wrutkowski/quadruped/docs/projects.md

---
layout: project
title: Videos
permalink: /videos/
---

A few videos of the robot.
