wrutkowski/quadruped/docs/_posts/2017-04-22-pwm-driver.md

---
layout: post
title:  "PWM Driver - a cure for shakes?"
date:   2017-04-22 14:00:00
---
I've received PWM Driver. I hoped that it will resolve shakes issue. I wanted to try it as soon as possible. Pins were not soldered so that was I first step.

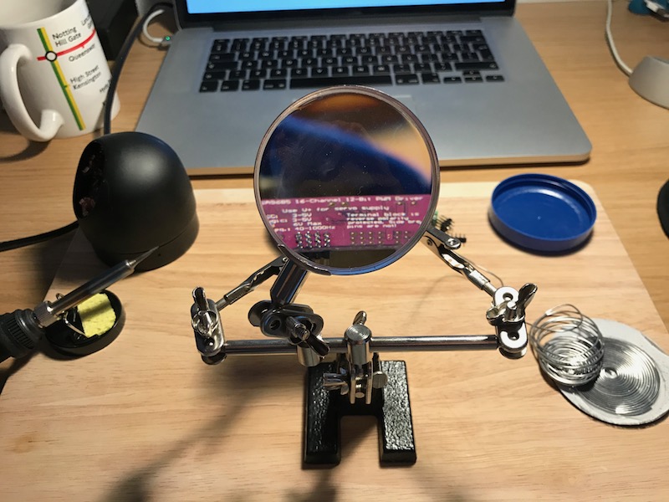
[picture p12: docs/assets/pwm-driver-soldering.jpg]
PRM Driver soldering


I placed 4 standoffs for PWM Driver on the robot body and then I connected all servos. I had to adjust servo-commander script as [PWM Driver library from Adafruit](https://github.com/adafruit/Adafruit-PWM-Servo-Driver-Library) accept _pulse width_ instead of angles as _Servo_ library.

I added for loop to change pulse width gradually hoping it'll help for the shakes as well.

```
void setServo(uint8_t servoNumber, int oldValue, int newValue, bool force = false) {
    if (newValue == oldValue && !force) return;

    if (newValue > oldValue) {
        for (uint16_t pulselen = oldValue; pulselen <= newValue; pulselen++) {
            pwm.setPWM(servoNumber, 0, pulselen);
        }
    } else {
        for (uint16_t pulselen = oldValue; pulselen >= newValue; pulselen--) {
            pwm.setPWM(servoNumber, 0, pulselen);
        }
    }
}
```

Standoffs ready for the Driver
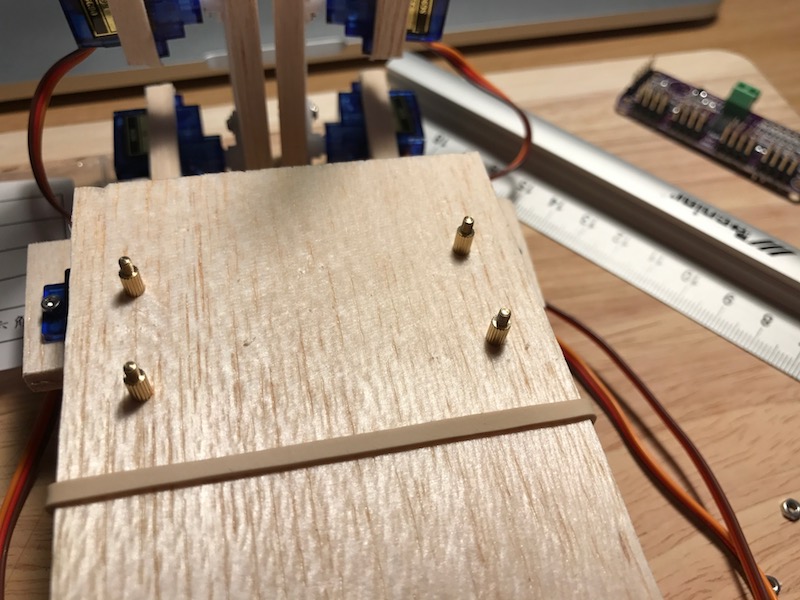
[picture p13: docs/assets/pwm-driver-standoffs.jpg]
Standoffs ready for the Driver


PWM Driver with servos connected
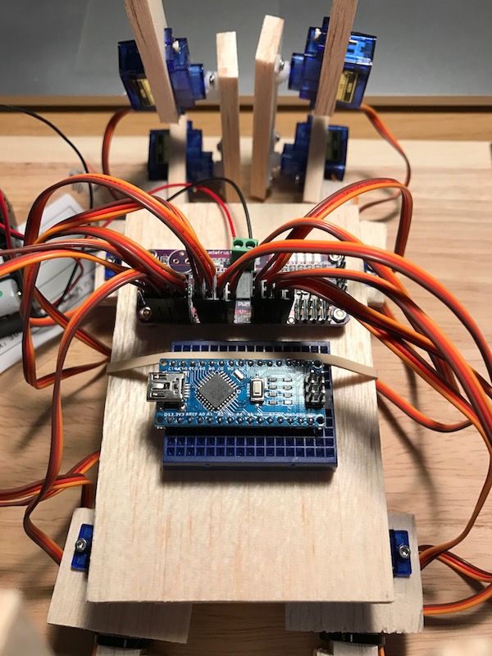
[picture p14: docs/assets/pwm-driver-with-servos-connected.jpg]
PWM Driver with servos connected


You can see PWM driver didn't help - shaking is still there.

PWM Driver - robot shakes

In the documentation I found the point about [soldering capacitor to the driver](https://learn.adafruit.com/16-channel-pwm-servo-driver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). For 12 servos it should be 1200uF capacitor. I didn't have one, but I'll grab one from the nearby electronic store tomorrow.
