wrutkowski/quadruped/docs/_posts/2017-05-20-new-construction-acrylic.md

---
layout: post
title:  "New construction - acrylic"
date:   2017-05-20 01:00:00
---
After trying to make balsa wood construction to work for a couple of times I decided I'll try shorter, more sturdy legs made from acrylic. I ordered 5 of those legs (one for a backup) from ebay.

I disassembled one leg and attached servos to the new acrylic parts.

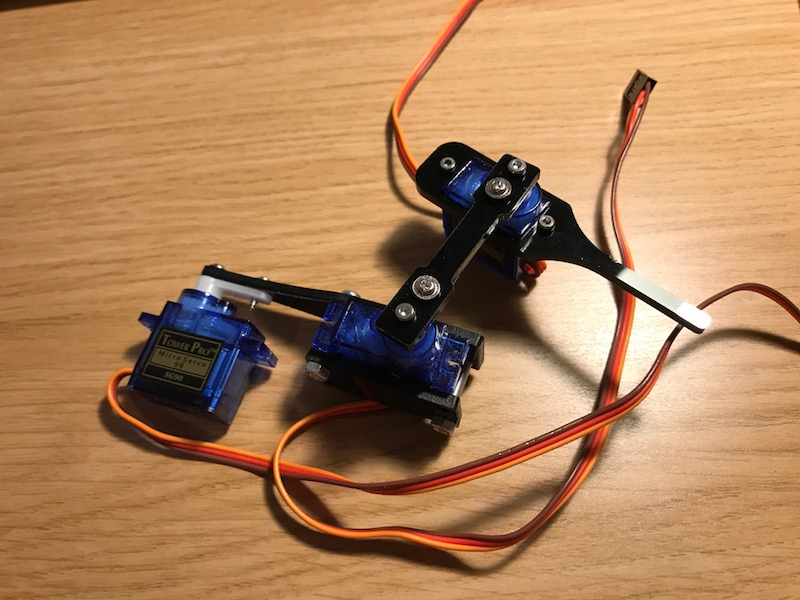
[picture p22: docs/assets/acrylic-leg-mounted.jpg]
Acrylic leg mounted


It was a lot more sturdy than longer balsa construction so I followed the same steps for other legs.

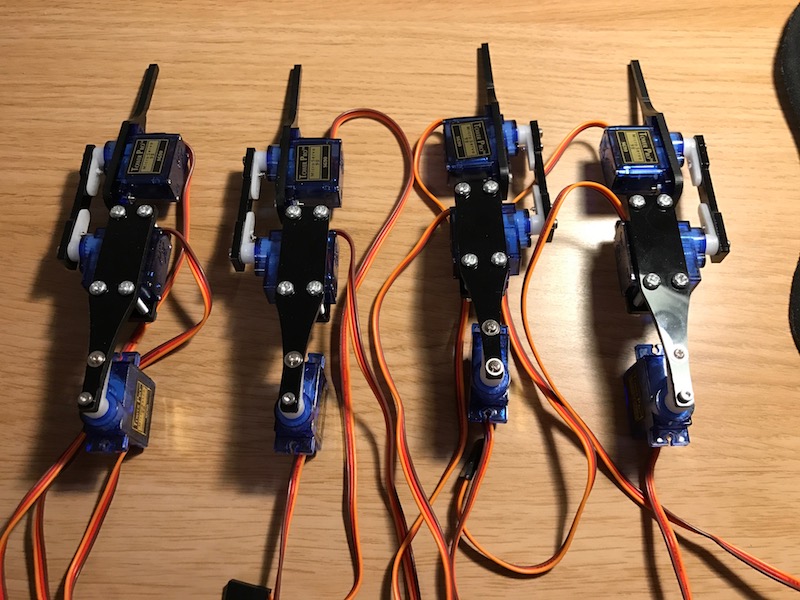
[picture p23: docs/assets/four-new-acrylic-legs.jpg]
4 new acrylic legs


Together with legs I ordered A4 sheet of 3mm acrylic to make a body. I cut 4 holes for servos and drilled several holes for screws for servos and pads for PWM Driver and on/off switch.

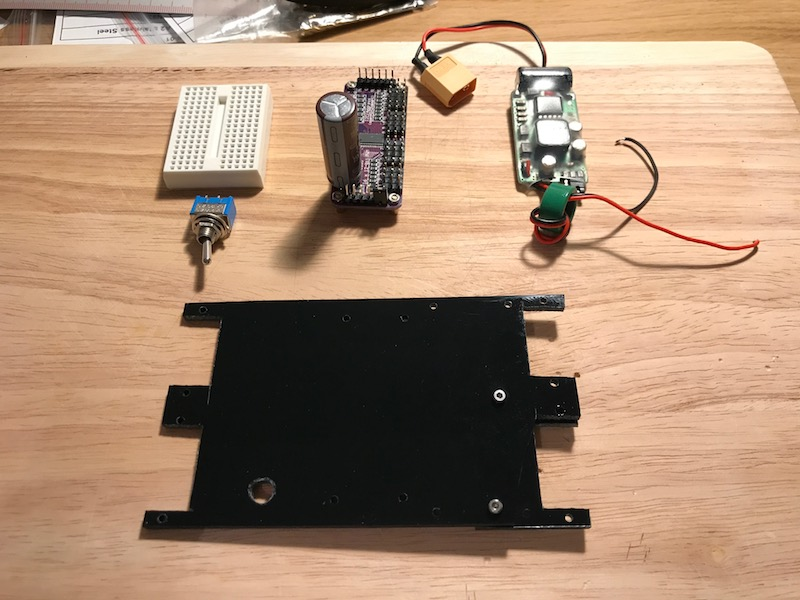
[picture p24: docs/assets/body-and-components.jpg]
Body and robot's components waiting to be installed


New acrylic construction:
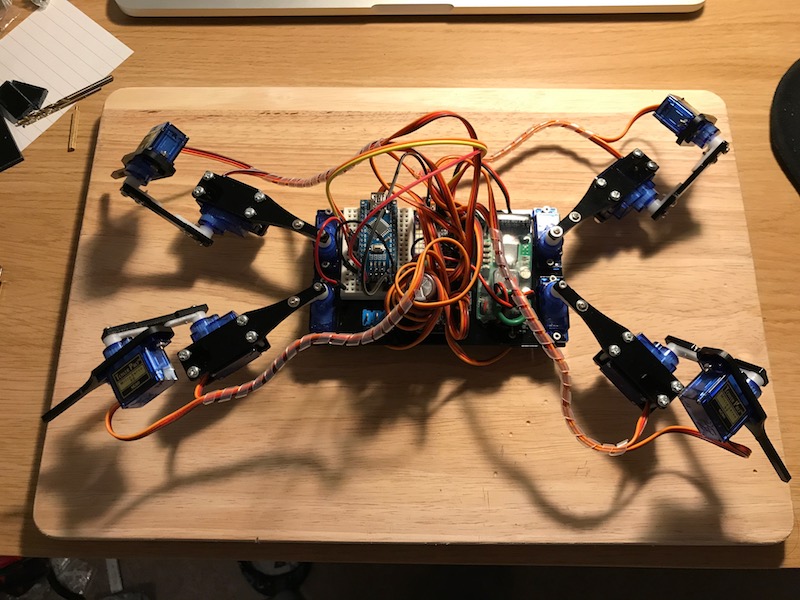
[picture p25: docs/assets/quadruped-new-acrylic-construction.jpg]
New acrylic construction


I adjusted body size and legs lengths settings in the code. Run calibration process again and without changing walk methods robot started walking for the first time! 😄

New Acrylic Robot Walking for the first time

It **was** worth switching to acrylic.
