wrutkowski/quadruped/docs/_posts/2017-04-19-servos-testing.md

---
layout: post
title:  "Servos testing + robot base with 4 legs"
date:   2017-04-19 20:00:00
---
Servos arrived. I tried to fit them to leg parts that I created several days ago as I’ve heard that cheap 9g servos can differ in sizes a bit. They were exactly the same size as my one old servo from previous project, so after some drilling and screwing first leg was ready.

First robot leg constructed with testing circuit

I don't have a PWM Driver yet and I didn't want to put USB under too much draw from three servos so I decided to create a simple circuit with potentiometer and a button. I read the analog input from the potentiometer to set the servo angle and button switches between hip, thigh and tibia servos. All worked OK and the material was sturdy enough so I decided to create other 3 legs.

Mass production begins 😄 It's just a quadruped, it's hard to imagine how repetitive it is for 6 or 8 leg robot.

Balsa wood elements cut
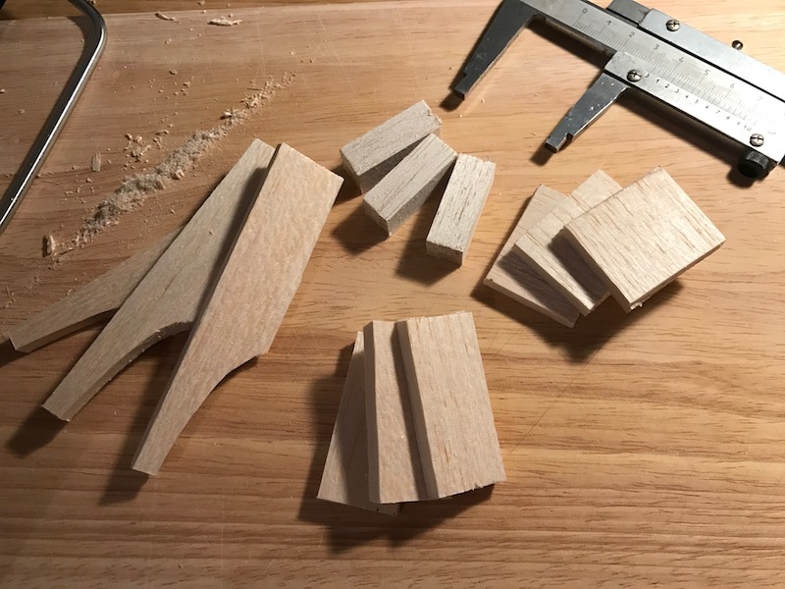
[picture p31: docs/assets/balsa-wood-elements-cut-for-3-legs.jpg]
Balsa wood elements cut


Clamp on glued hip-thigh element
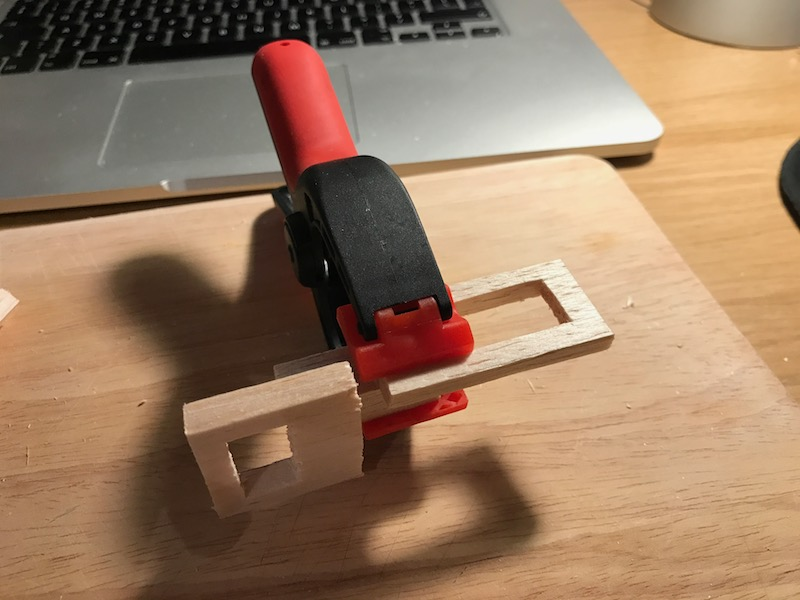
[picture p32: docs/assets/clamp-on-glued-hip-thigh-element.jpg]
Clamp on glued hip-thigh element


Thigh with servo full arms attached
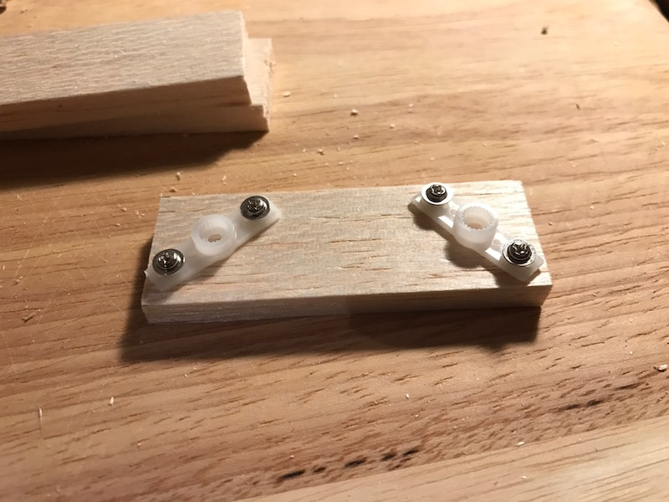
[picture p33: docs/assets/thigh-with-servo-full-arms-attached.jpg]
Thigh with servo full arms attached


Legs are ready!
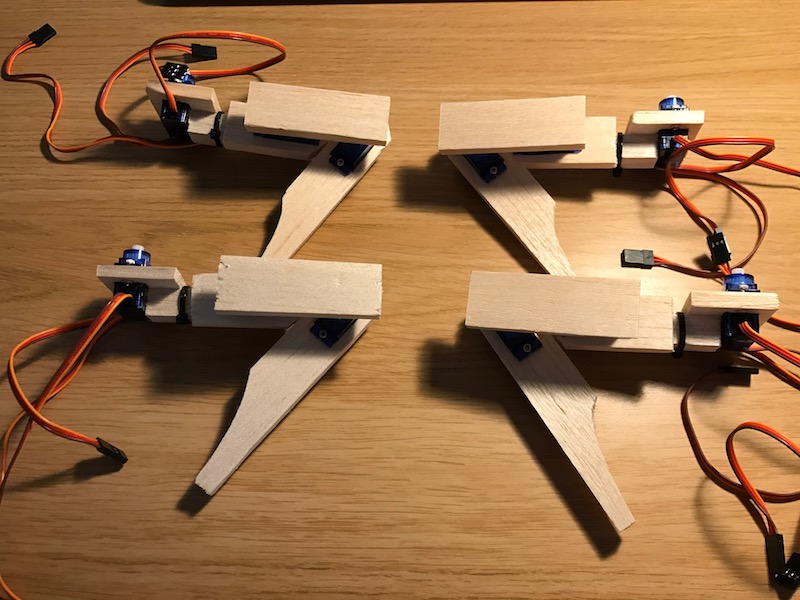
[picture p34: docs/assets/quadruped-three-new-legs.jpg]
Legs are ready!


And finally connected to the robot
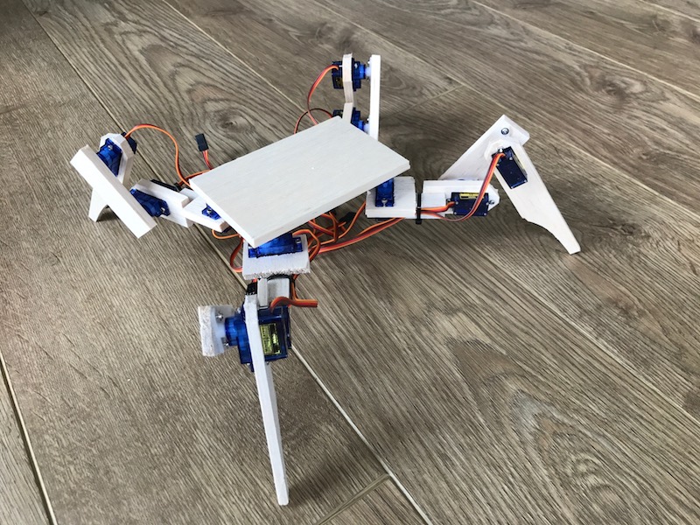
[picture p35: docs/assets/robot-body-with-legs-attached.jpg]
And finally connected to the robot
