wrutkowski/quadruped/(list of files, drawings)

Other design files:
arduino/_libraries/rfid/doc/fritzing/Arduino-Uno-r3-with-RFID-RC522.fzz
arduino/_libraries/Ultrasonic/extras/Ultrasonic.fzz
