wrutkowski/quadruped/arduino/rfid-controlled-oled/rfid-controlled-oled.ino

/* Typical pin layout used:
 * -----------------------------------------------------------------------------------------
 *             MFRC522      Arduino       Arduino   Arduino    Arduino          Arduino
 *             Reader/PCD   Uno/101       Mega      Nano v3    Leonardo/Micro   Pro Micro
 * Signal      Pin          Pin           Pin       Pin        Pin              Pin
 * -----------------------------------------------------------------------------------------
 * RST/Reset   RST          9             5         D9         RESET/ICSP-5     RST
 * SPI SS      SDA(SS)      10            53        D10        10               10
 * SPI MOSI    MOSI         11 / ICSP-4   51        D11        ICSP-4           16
 * SPI MISO    MISO         12 / ICSP-1   50        D12        ICSP-1           14
 * SPI SCK     SCK          13 / ICSP-3   52        D13        ICSP-3           15
 */

#include <SPI.h>
#include <MFRC522.h>
#include "SH1106_SPI.h"

#define RST_PIN         7     
#define SS_PIN          6    

MFRC522 mfrc522(SS_PIN, RST_PIN);
SH1106_SPI_FB lcd;
uint8_t smile_step = 0;
uint8_t smile_steps = 4;

byte keyringRFID[4] = {0xF5, 0x68, 0xCD, 0x65};
byte cardRFID[4] = {0x68, 0x4D, 0xEC, 0x10};
byte readCard[4];

void setup(void) {
    Serial.begin(9600);
    SPI.begin();
    mfrc522.PCD_Init();    
//    mfrc522.PCD_DumpVersionToSerial();  // Show details of PCD - MFRC522 Card Reader details

    lcd.begin();
    
    Serial.println("Ready!");
}

void loop() {
    lcd.clear();

    if (getID()) {
        if (checkRFID(readCard, keyringRFID)) {
            Serial.println("keyring detected");
            emotion_happiness();
            lcd.renderAll();
            delay(1000);
        } else if (checkRFID(readCard, cardRFID)) {
            Serial.println("card detected");
            emotion_sadness();
            lcd.renderAll();
            delay(1000);
        }
    } else {
        if (smile_step == 0) emotion_looking_around_1();
        if (smile_step == 1) emotion_looking_around_2();
        if (smile_step == 2) emotion_looking_around_1();
        if (smile_step == 3) emotion_looking_around_3();
        lcd.renderAll();

        delay(400);
        
        smile_step++;
        if (smile_step >= smile_steps) smile_step = 0;
    }
}

uint8_t getID() {
    // Getting ready for Reading PICCs
    if ( ! mfrc522.PICC_IsNewCardPresent()) { //If a new PICC placed to RFID reader continue
        return 0;
    }
    if ( ! mfrc522.PICC_ReadCardSerial()) {   //Since a PICC placed get Serial and continue
        return 0;
    } 
    for ( uint8_t i = 0; i < 4; i++) {  //
        readCard[i] = mfrc522.uid.uidByte[i];
//        Serial.print(readCard[i], HEX);
    }
  
    mfrc522.PICC_HaltA(); // Stop reading
    return 1;
}

boolean checkRFID ( byte a[], byte b[] ) {
    boolean match = false;
    if ( a[0] != 0 ) {
        match = true;       // Assume they match at first
    }
    
    for (uint8_t k = 0; k < 4; k++ ) {
        if (a[k] != b[k]) {     // IF a != b then set match = false, one fails, all fail
            match = false;
        }
    }
    return match;
}

// emotions

void emotion_anger() {
    lcd.setPixel(38, 51, 1); lcd.setPixel(39, 50, 1); lcd.setPixel(39, 51, 1); lcd.setPixel(39, 52, 1); lcd.setPixel(40, 50, 1); lcd.setPixel(40, 51, 1); lcd.setPixel(40, 52, 1); lcd.setPixel(41, 49, 1); lcd.setPixel(41, 50, 1); lcd.setPixel(41, 51, 1); lcd.setPixel(41, 52, 1); lcd.setPixel(42, 48, 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
}

void emotion_happiness() {
    lcd.setPixel(39, 20, 1); lcd.setPixel(39, 21, 1); lcd.setPixel(40, 18, 1); lcd.setPixel(40, 19, 1); lcd.setPixel(40, 20, 1); lcd.setPixel(40, 21, 1); lcd.setPixel(40, 22, 1); lcd.setPixel(41, 17, 1); lcd.setPixel(41, 18, 1); lcd.setPixel(41, 19, 1); lcd.setPixel(41, 20, 1); lcd.setPixel(41, 21, 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
}

void emotion_idle() {
    lcd.setPixel(38, 40, 1); lcd.setPixel(39, 39, 1); lcd.setPixel(39, 40, 1); lcd.setPixel(39, 41, 1); lcd.setPixel(40, 39, 1); lcd.setPixel(40, 40, 1); lcd.setPixel(40, 41, 1); lcd.setPixel(40, 42, 1); lcd.setPixel(41, 17, 1); lcd.setPixel(41, 18, 1); lcd.setPixel(41, 19, 1); lcd.setPixel(41, 20, 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
}

void emotion_looking_around_1() {
    lcd.setPixel(38, 40, 1); lcd.setPixel(39, 39, 1); lcd.setPixel(39, 40, 1); lcd.setPixel(39, 41, 1); lcd.setPixel(40, 39, 1); lcd.setPixel(40, 40, 1); lcd.setPixel(40, 41, 1); lcd.setPixel(40, 42, 1); lcd.setPixel(41, 40, 1); lcd.setPixel(41, 41, 1); lcd.setPixel(41, 42, 1); lcd.setPixel(42, 15, 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
}

void emotion_looking_around_2() {
    lcd.setPixel(38, 40, 1); lcd.setPixel(39, 39, 1); lcd.setPixel(39, 40, 1); lcd.setPixel(39, 41, 1); lcd.setPixel(40, 39, 1); lcd.setPixel(40, 40, 1); lcd.setPixel(40, 41, 1); lcd.setPixel(40, 42, 1); lcd.setPixel(41, 22, 1); lcd.setPixel(41, 23, 1); lcd.setPixel(41, 24, 1); lcd.setPixel(41, 25, 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
}

void emotion_looking_around_3() {
    lcd.setPixel(38, 40, 1); lcd.setPixel(39, 39, 1); lcd.setPixel(39, 40, 1); lcd.setPixel(39, 41, 1); lcd.setPixel(40, 39, 1); lcd.setPixel(40, 40, 1); lcd.setPixel(40, 41, 1); lcd.setPixel(40, 42, 1); lcd.setPixel(41, 40, 1); lcd.setPixel(41, 41, 1); lcd.setPixel(41, 42, 1); lcd.setPixel(42, 15, 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
}

void emotion_sadness() {
    lcd.setPixel(36, 23, 1); lcd.setPixel(37, 23, 1); lcd.setPixel(37, 24, 1); lcd.setPixel(37, 25, 1); lcd.setPixel(38, 22, 1); lcd.setPixel(38, 23, 1); lcd.setPixel(38, 24, 1); lcd.setPixel(38, 53, 1); lcd.setPixel(39, 21, 1); lcd.setPixel(39, 22, 1); lcd.setPixel(39, 23, 1); lcd.setPixel(39, 24, 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
}
