wrutkowski/quadruped/(commit log)

2017-04-05 Simulator in current stage added: 4 controllable legs + adjustable dimensions of the robot + pre set positions and animations
2017-04-12 Added balsa wood leg picture
2017-04-15 RFID library and example + doc fix
    [Arduino-Uno-r3-with-RFID-RC522.fzz]
2017-04-16 Ultrasonic + RFID, Ultrasonic and OLED demo
    [Ultrasonic.fzz]
2017-04-17 Doc: RFID and Ultrasonic sonar controlling OLED Display
2017-04-18 Docs: RFID and Ultrasonic memory stats
2017-04-18 One leg servo tester: analog read from potentiometer and a button for switching joint to control
2017-05-06 Docs: New posts added for servos and PWM Driver
2017-05-24 Updated servo output pins for new model + Added structs representing legs and their movement + Moved to ratio values instead of direct mm + Added DEBUG mode for Serial printing + Added Forward Walk +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
